caelangillon/microfluidic-pump/README.md

# microfluidic-pump

Colation of all software-relevant files of the Microfluidic Pump project.
May also contain some other files for document creation.
