caelangillon/microfluidic-pump/MATLAB/README.MD

# MATLAB Files
MATLAB prototyping files, includes:
- Simulations
- Prototype Arduino build files (Simulink)
- Testing UI and data
