caelangillon/microfluidic-pump/Diagrams/methodology.png

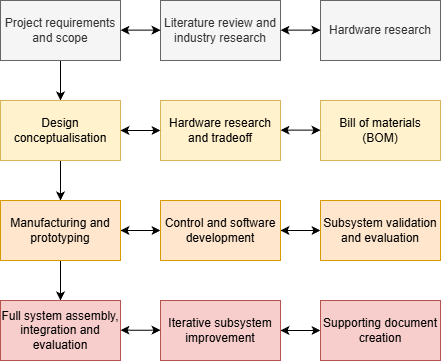
Diagrams/methodology.png
