caelangillon/microfluidic-pump/Diagrams/parallelmethod.png

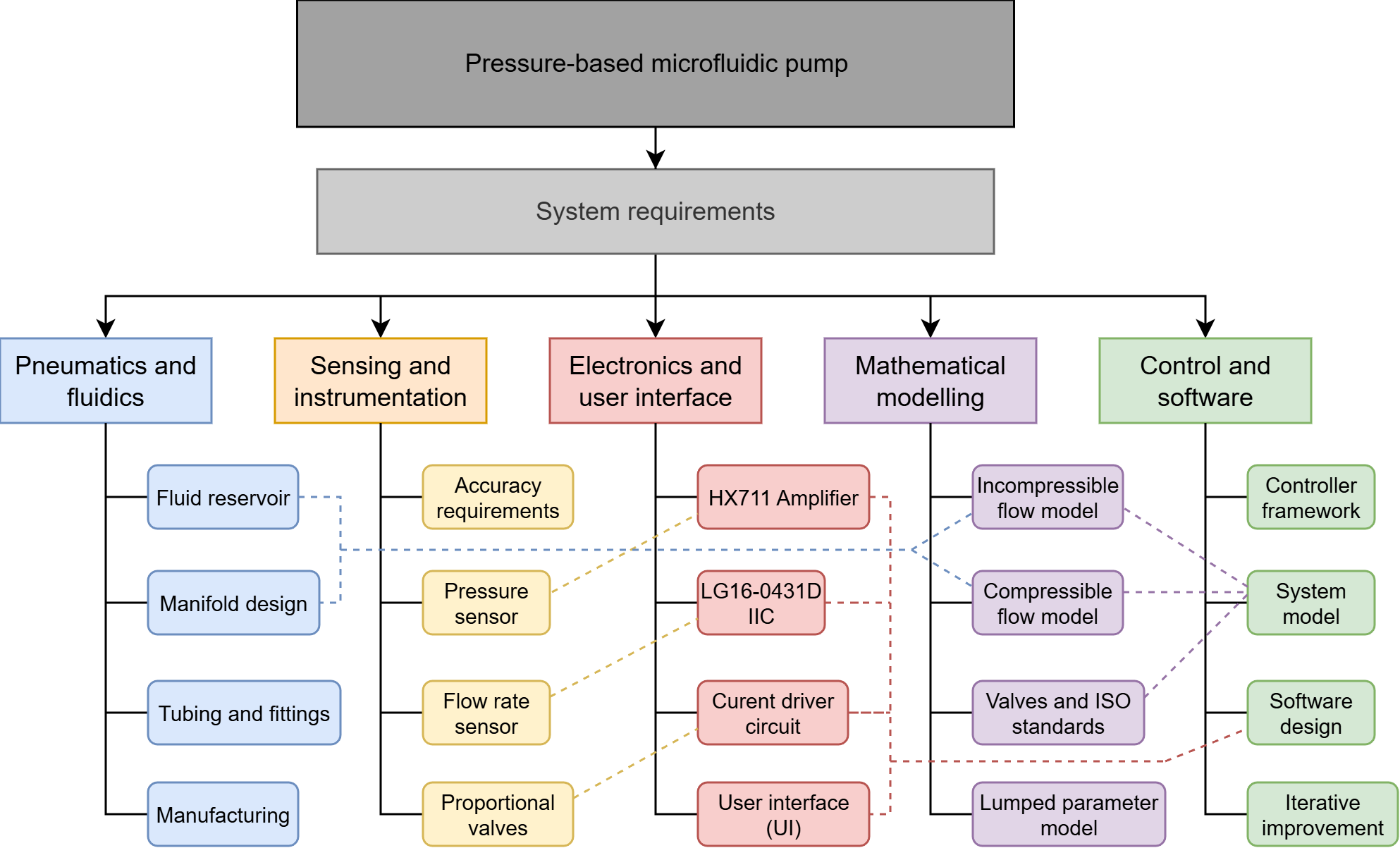
Diagrams/parallelmethod.png
