caelangillon/microfluidic-pump/Diagrams/Preliminary Circuit Layout.png

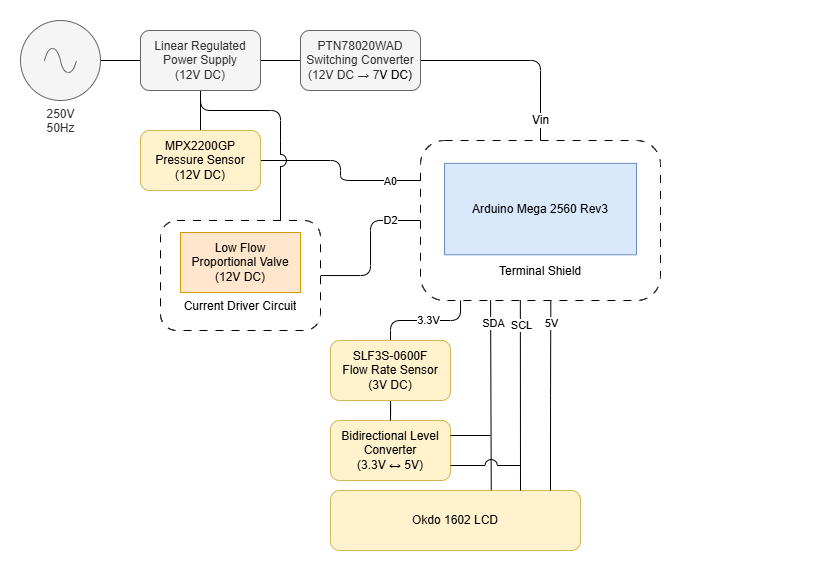
Diagrams/Preliminary Circuit Layout.png
