caelangillon/microfluidic-pump/Diagrams/Semester Breakdown.png

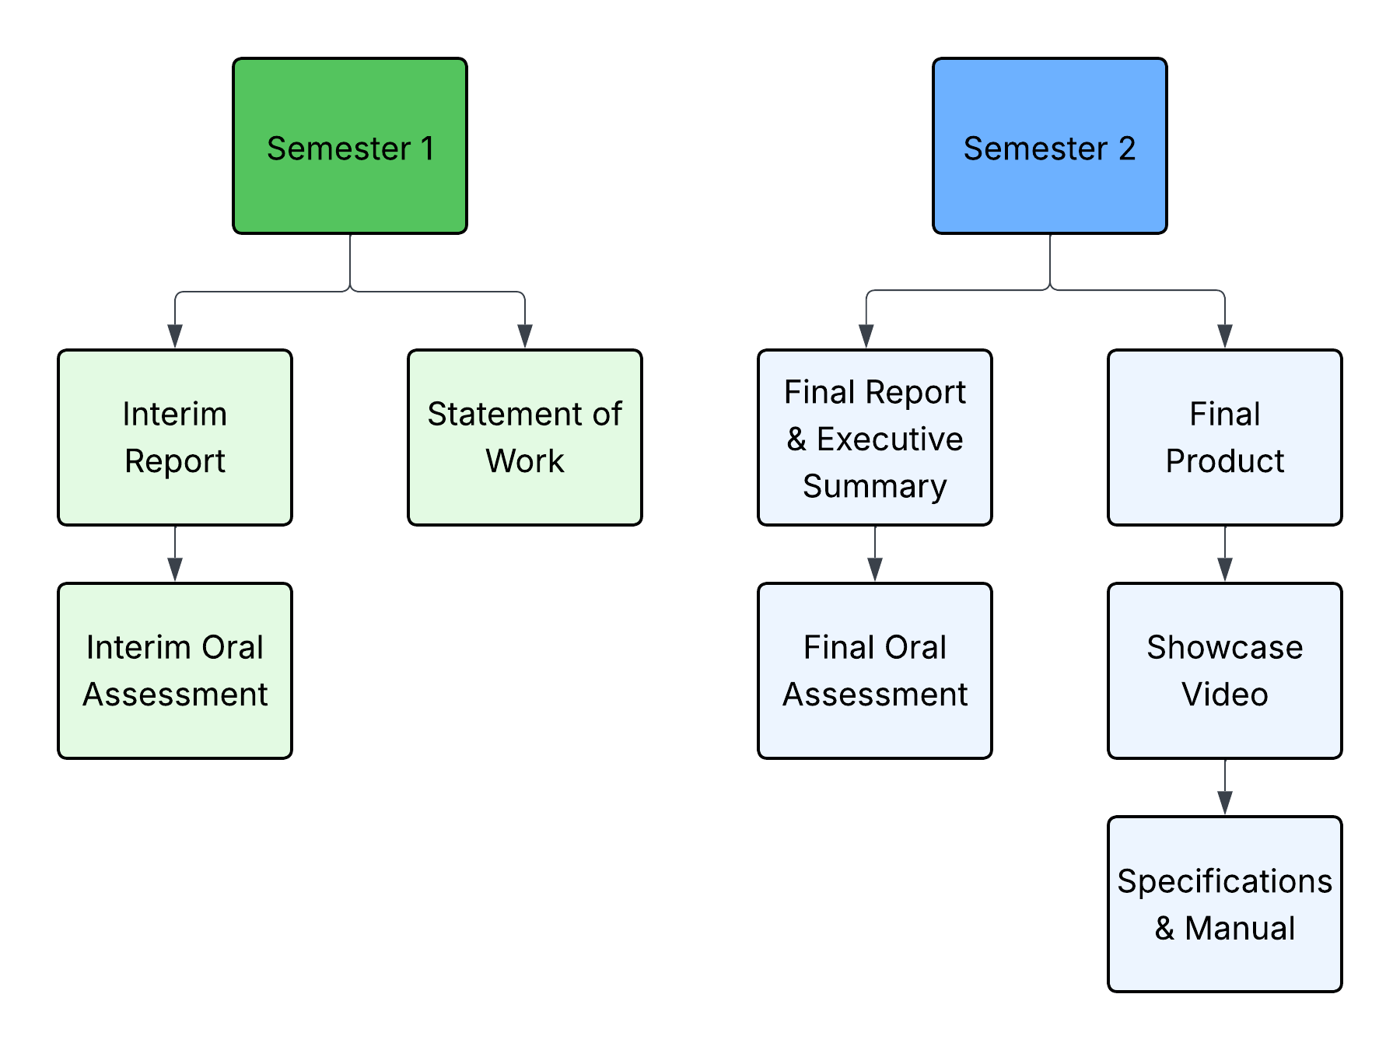
Diagrams/Semester Breakdown.png
