caelangillon/microfluidic-pump/Diagrams/Stakeholders.png

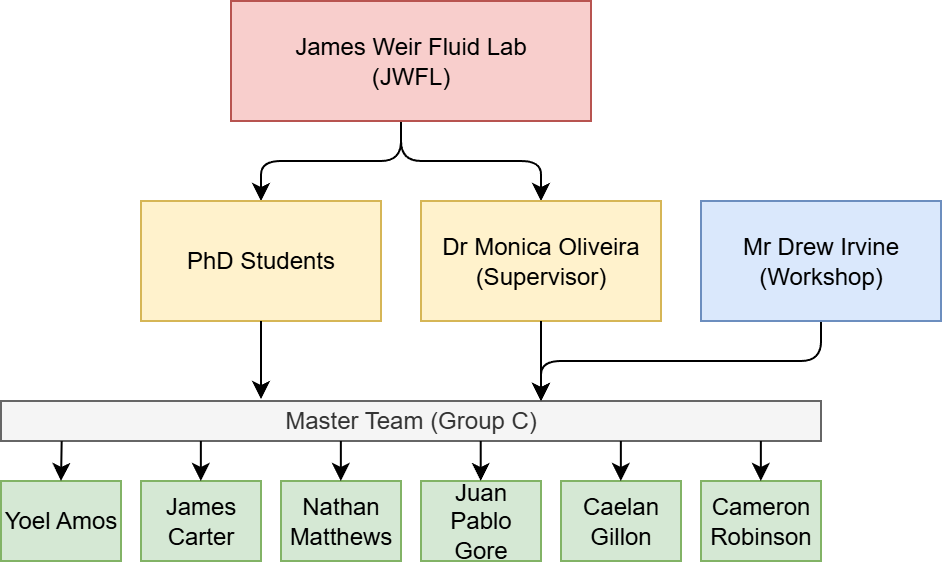
Diagrams/Stakeholders.png
