caelangillon/microfluidic-pump/Diagrams/Work Breakdown (Original).png

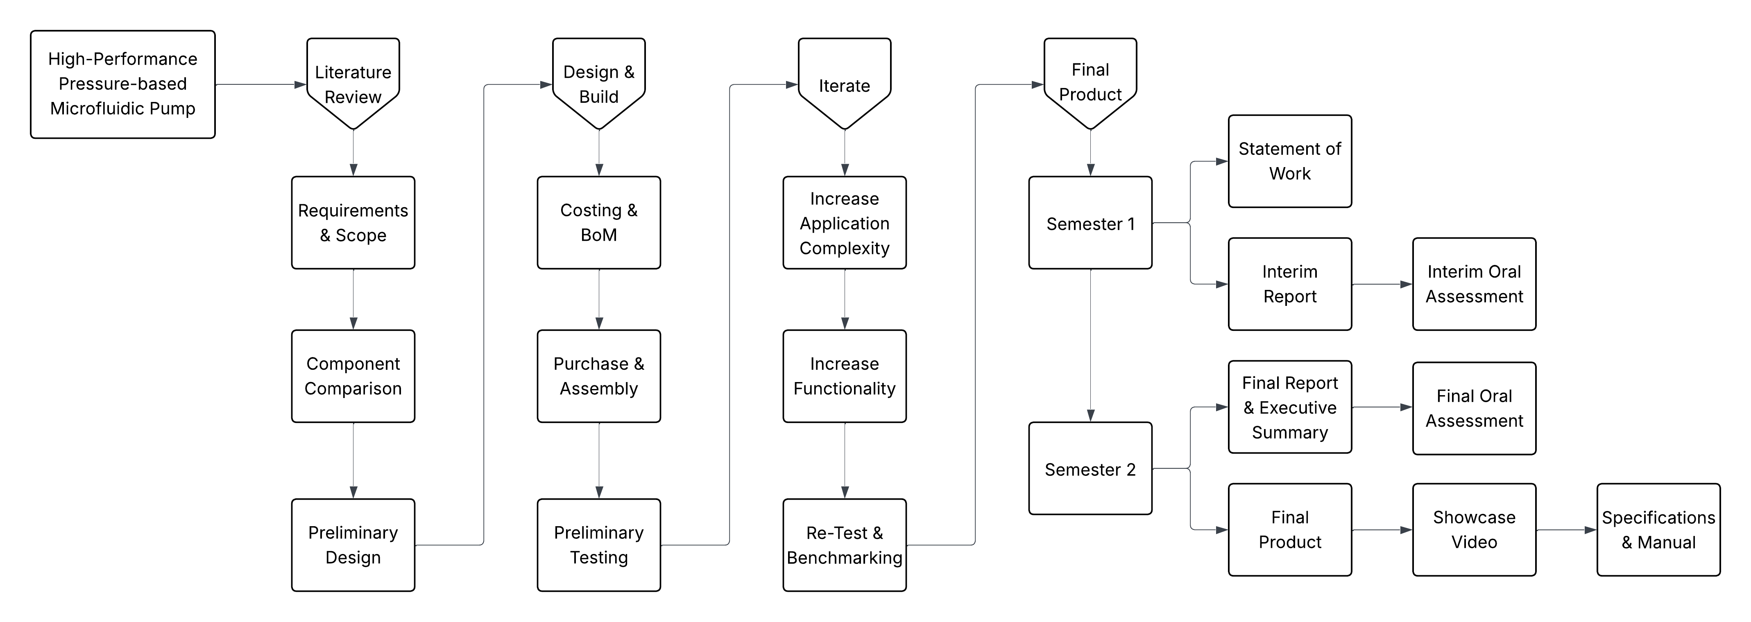
Diagrams/Work Breakdown (Original).png
