caelangillon/microfluidic-pump/Diagrams/Work Breakdown.png

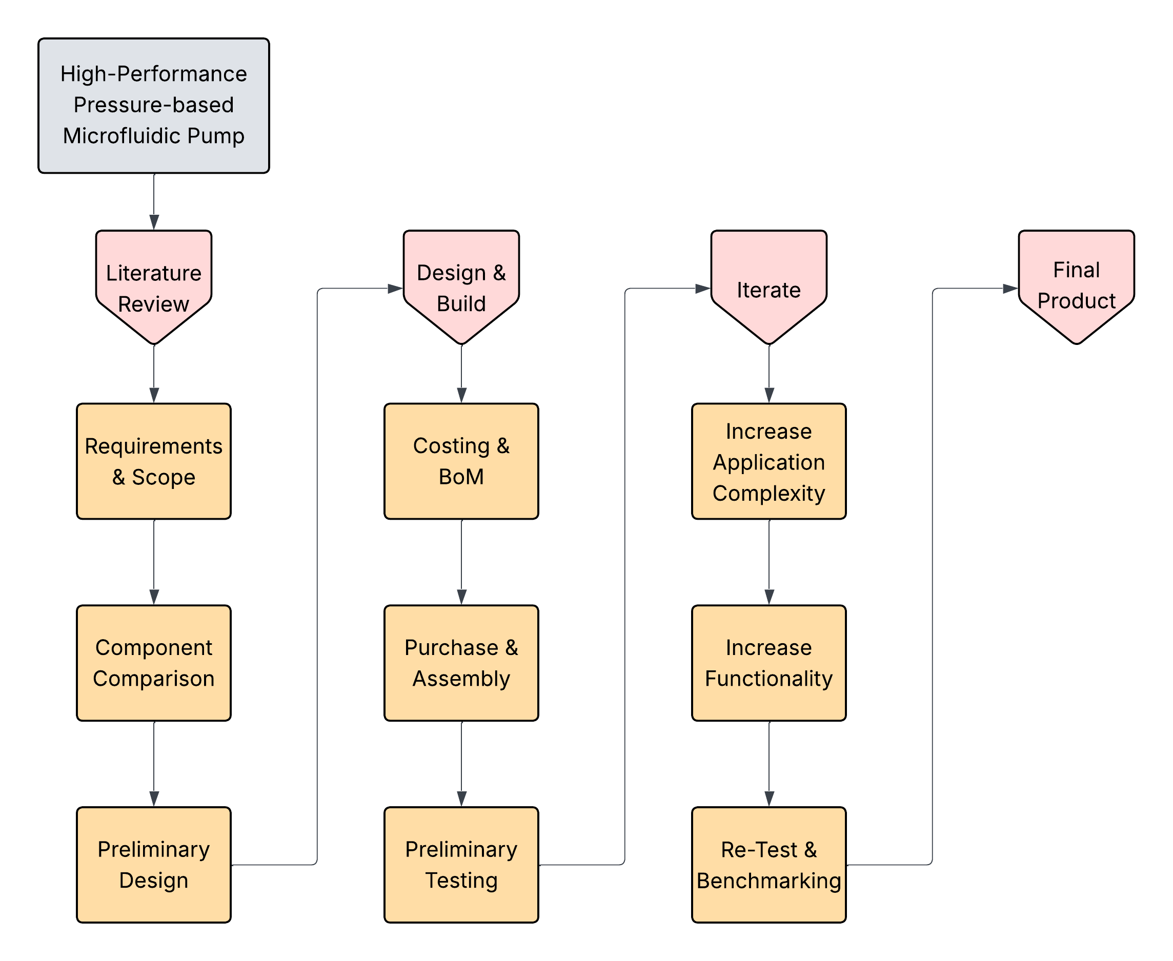
Diagrams/Work Breakdown.png
