caelangillon/microfluidic-pump/3D Prints/Reservoir Bottom.STL

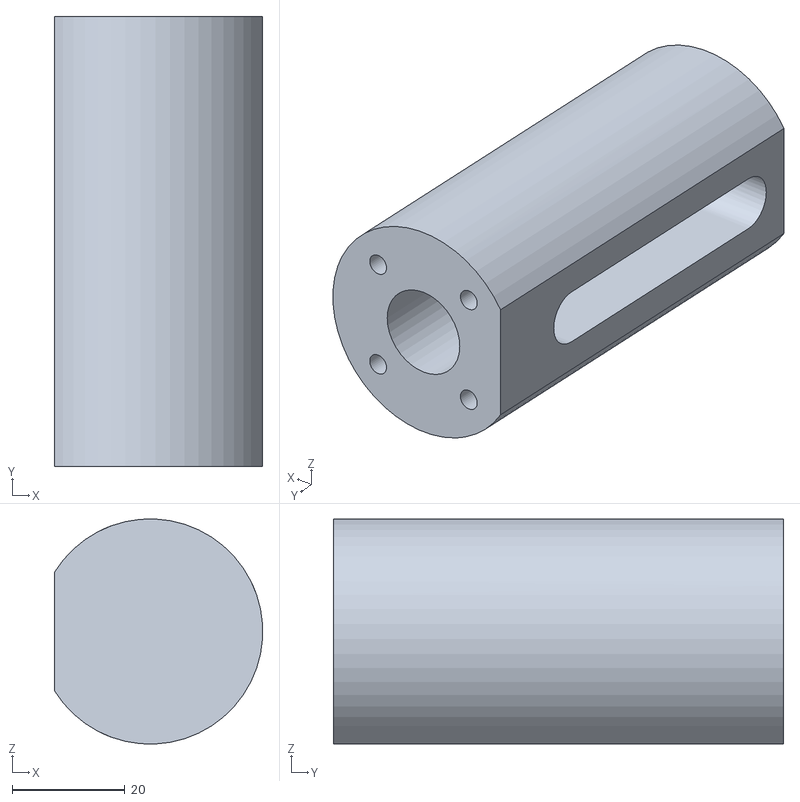
[picture p21: CAD file, 2025-11-24]
3D Prints/Reservoir Bottom.STL
37.0 x 80.0 x 40.0
