caelangillon/microfluidic-pump/3D Prints/Manifold.STL

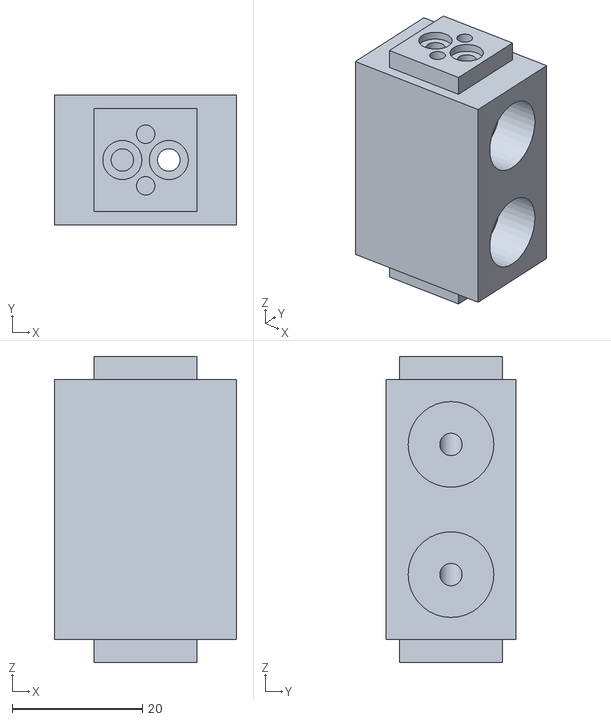
[picture p22: CAD file, 2025-11-24]
3D Prints/Manifold.STL
28.0 x 20.0 x 47.0
