caelangillon/microfluidic-pump/3D Prints/Reservoir Cap.STL

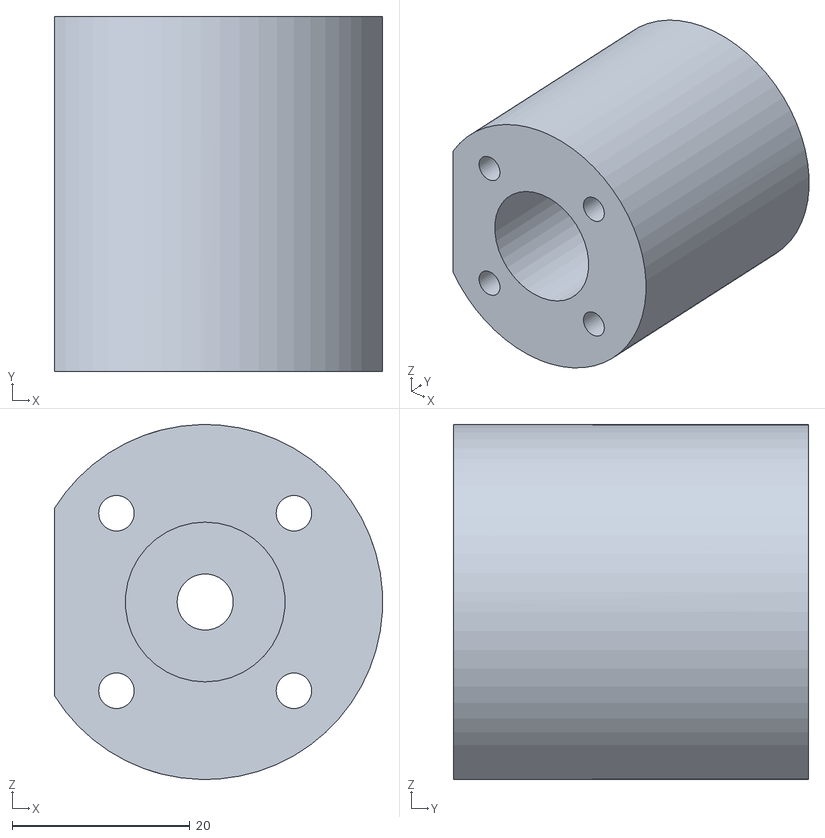
[picture p23: CAD file, 2025-11-24]
3D Prints/Reservoir Cap.STL
37.0 x 40.0 x 40.0
