caelangillon/microfluidic-pump/Diagrams/Assembly Instructions/manifold1.png

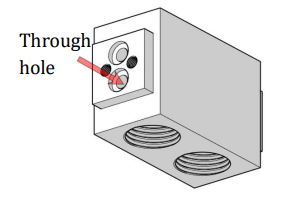
Diagrams/Assembly Instructions/manifold1.png
