caelangillon/microfluidic-pump/Diagrams/Assembly Instructions/manifold2.png

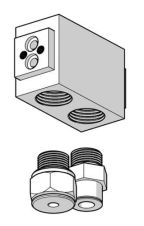
Diagrams/Assembly Instructions/manifold2.png
