caelangillon/microfluidic-pump/Diagrams/Assembly Instructions/manifold3.png

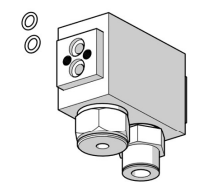
Diagrams/Assembly Instructions/manifold3.png
