caelangillon/microfluidic-pump/Diagrams/Assembly Instructions/manifold4.png

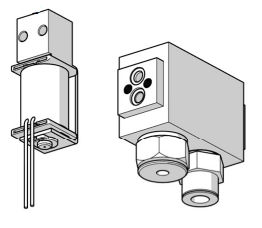
Diagrams/Assembly Instructions/manifold4.png
