caelangillon/microfluidic-pump/Diagrams/Assembly Instructions/manifold5.png

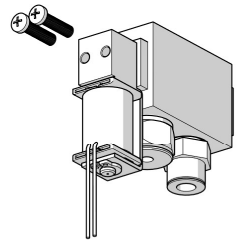
Diagrams/Assembly Instructions/manifold5.png
