caelangillon/microfluidic-pump/Diagrams/Assembly Instructions/manifold6.png

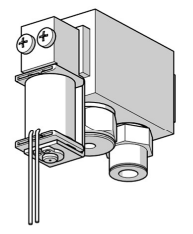
Diagrams/Assembly Instructions/manifold6.png
