caelangillon/microfluidic-pump/Diagrams/Assembly Instructions/manifold7.png

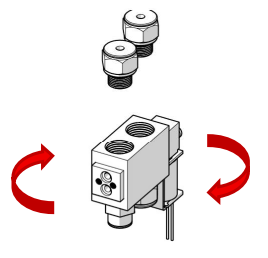
Diagrams/Assembly Instructions/manifold7.png
