caelangillon/microfluidic-pump/Diagrams/Assembly Instructions/manifold8.png

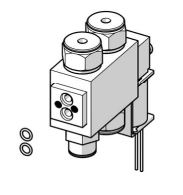
Diagrams/Assembly Instructions/manifold8.png
