caelangillon/microfluidic-pump/Diagrams/Assembly Instructions/manifold9.png

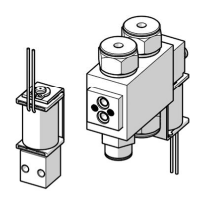
Diagrams/Assembly Instructions/manifold9.png
