caelangillon/microfluidic-pump/Diagrams/Assembly Instructions/manifold10.png

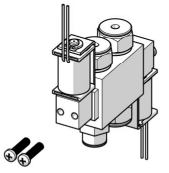
Diagrams/Assembly Instructions/manifold10.png
