caelangillon/microfluidic-pump/Diagrams/Assembly Instructions/manifold11.png

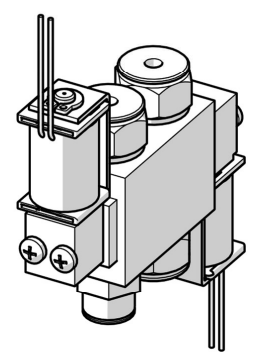
Diagrams/Assembly Instructions/manifold11.png
