caelangillon/microfluidic-pump/Diagrams/Assembly Instructions/reservoir1.png

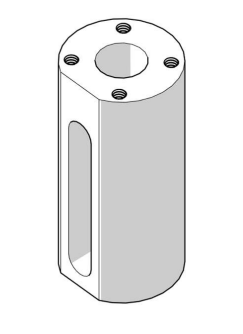
Diagrams/Assembly Instructions/reservoir1.png
