caelangillon/microfluidic-pump/Diagrams/Assembly Instructions/Reservoir3.png

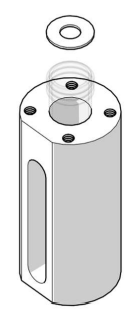
Diagrams/Assembly Instructions/Reservoir3.png
