caelangillon/microfluidic-pump/Diagrams/Assembly Instructions/Reservoir4.png

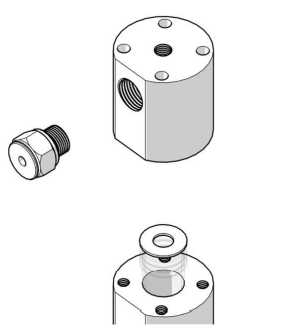
Diagrams/Assembly Instructions/Reservoir4.png
