caelangillon/microfluidic-pump/Diagrams/Assembly Instructions/Reservoir5.png

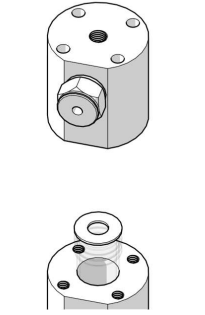
Diagrams/Assembly Instructions/Reservoir5.png
