caelangillon/microfluidic-pump/Diagrams/Assembly Instructions/Reservoir6.png

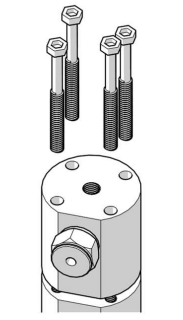
Diagrams/Assembly Instructions/Reservoir6.png
