caelangillon/microfluidic-pump/Diagrams/Assembly Instructions/Reservoir7.png

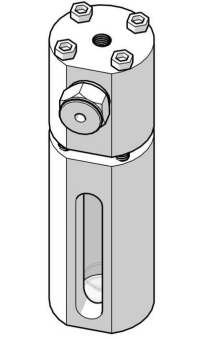
Diagrams/Assembly Instructions/Reservoir7.png
