caelangillon/microfluidic-pump/Diagrams/Assembly Instructions/restubing2.png

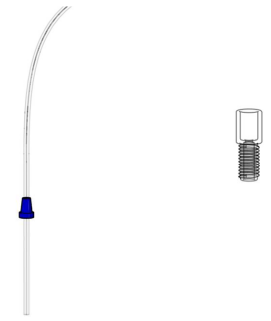
Diagrams/Assembly Instructions/restubing2.png
