caelangillon/microfluidic-pump/Diagrams/Assembly Instructions/restubing3.png

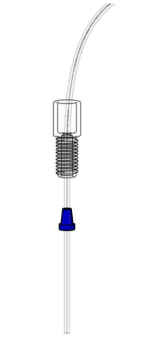
Diagrams/Assembly Instructions/restubing3.png
