caelangillon/microfluidic-pump/Diagrams/Assembly Instructions/restubing4.png

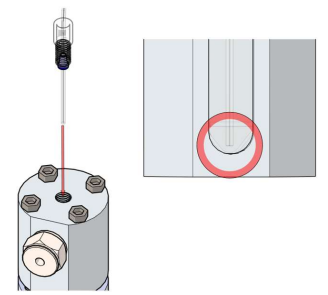
Diagrams/Assembly Instructions/restubing4.png
