caelangillon/microfluidic-pump/Diagrams/Assembly Instructions/restubing5.png

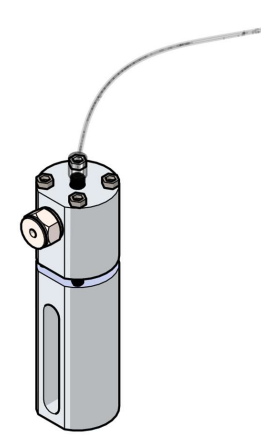
Diagrams/Assembly Instructions/restubing5.png
