caelangillon/microfluidic-pump/Results/frs_calib_test1.csv

6.999999999999999556e-01
2.427100000000000080e+02
1.000000000000000021e-02
2.000000000000000042e-02
2.000000000000000042e-02
1.000000000000000021e-02
1.000000000000000021e-02
0.000000000000000000e+00
1.000000000000000021e-02
1.000000000000000021e-02
0.000000000000000000e+00
0.000000000000000000e+00
0.000000000000000000e+00
1.000000000000000021e-02
2.427199999999999989e+02
1.000000000000000021e-02
0.000000000000000000e+00
0.000000000000000000e+00
1.000000000000000021e-02
1.000000000000000021e-02
1.000000000000000021e-02
1.000000000000000021e-02
0.000000000000000000e+00
1.000000000000000021e-02
0.000000000000000000e+00
2.427199999999999989e+02
2.427100000000000080e+02
2.427100000000000080e+02
2.427100000000000080e+02
2.427100000000000080e+02
1.000000000000000021e-02
0.000000000000000000e+00
0.000000000000000000e+00
1.000000000000000021e-02
1.000000000000000021e-02
0.000000000000000000e+00
2.427199999999999989e+02
2.427100000000000080e+02
2.427100000000000080e+02
2.427199999999999989e+02
0.000000000000000000e+00
2.427199999999999989e+02
0.000000000000000000e+00
0.000000000000000000e+00
2.427199999999999989e+02
1.000000000000000021e-02
0.000000000000000000e+00
0.000000000000000000e+00
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
