caelangillon/microfluidic-pump/Results/frs_calib_test3.csv

1.400000000000000133e-01
1.400000000000000133e-01
1.300000000000000044e-01
1.199999999999999956e-01
1.000000000000000056e-01
1.100000000000000006e-01
1.100000000000000006e-01
1.000000000000000056e-01
1.000000000000000056e-01
1.000000000000000056e-01
1.000000000000000056e-01
1.000000000000000056e-01
8.999999999999999667e-02
1.000000000000000056e-01
1.000000000000000056e-01
1.000000000000000056e-01
1.100000000000000006e-01
8.999999999999999667e-02
1.000000000000000056e-01
8.999999999999999667e-02
1.000000000000000056e-01
8.000000000000000167e-02
7.000000000000000666e-02
7.000000000000000666e-02
8.999999999999999667e-02
8.999999999999999667e-02
8.000000000000000167e-02
7.000000000000000666e-02
7.000000000000000666e-02
8.000000000000000167e-02
8.999999999999999667e-02
7.000000000000000666e-02
8.000000000000000167e-02
5.999999999999999778e-02
5.999999999999999778e-02
5.000000000000000278e-02
4.000000000000000083e-02
2.999999999999999889e-02
1.000000000000000021e-02
1.000000000000000021e-02
2.427199999999999989e+02
1.000000000000000021e-02
2.427199999999999989e+02
0.000000000000000000e+00
2.427100000000000080e+02
0.000000000000000000e+00
0.000000000000000000e+00
1.000000000000000021e-02
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
