caelangillon/microfluidic-pump/Results/frs_calib_test1.png

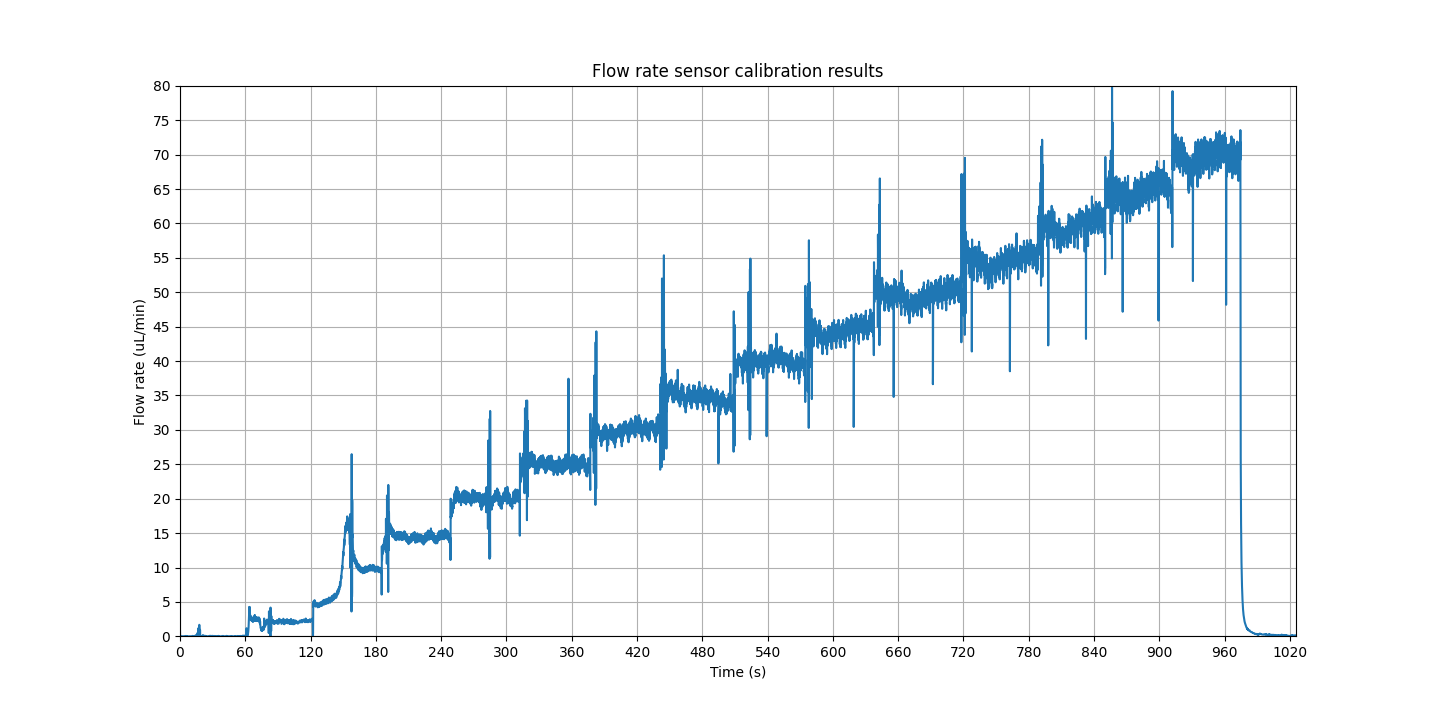
Results/frs_calib_test1.png
