caelangillon/microfluidic-pump/Results/frs_calib_test2.png

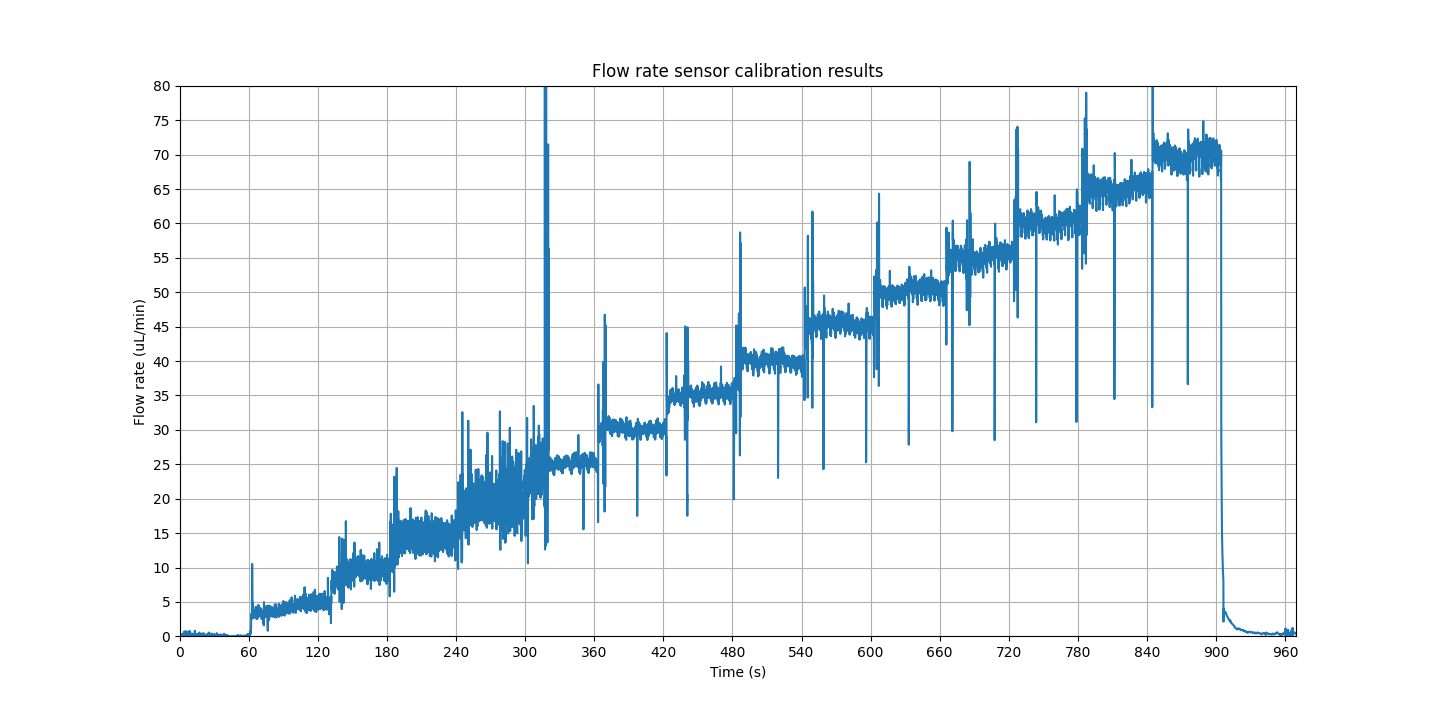
Results/frs_calib_test2.png
