caelangillon/microfluidic-pump/Results/frs_calib_test3.png

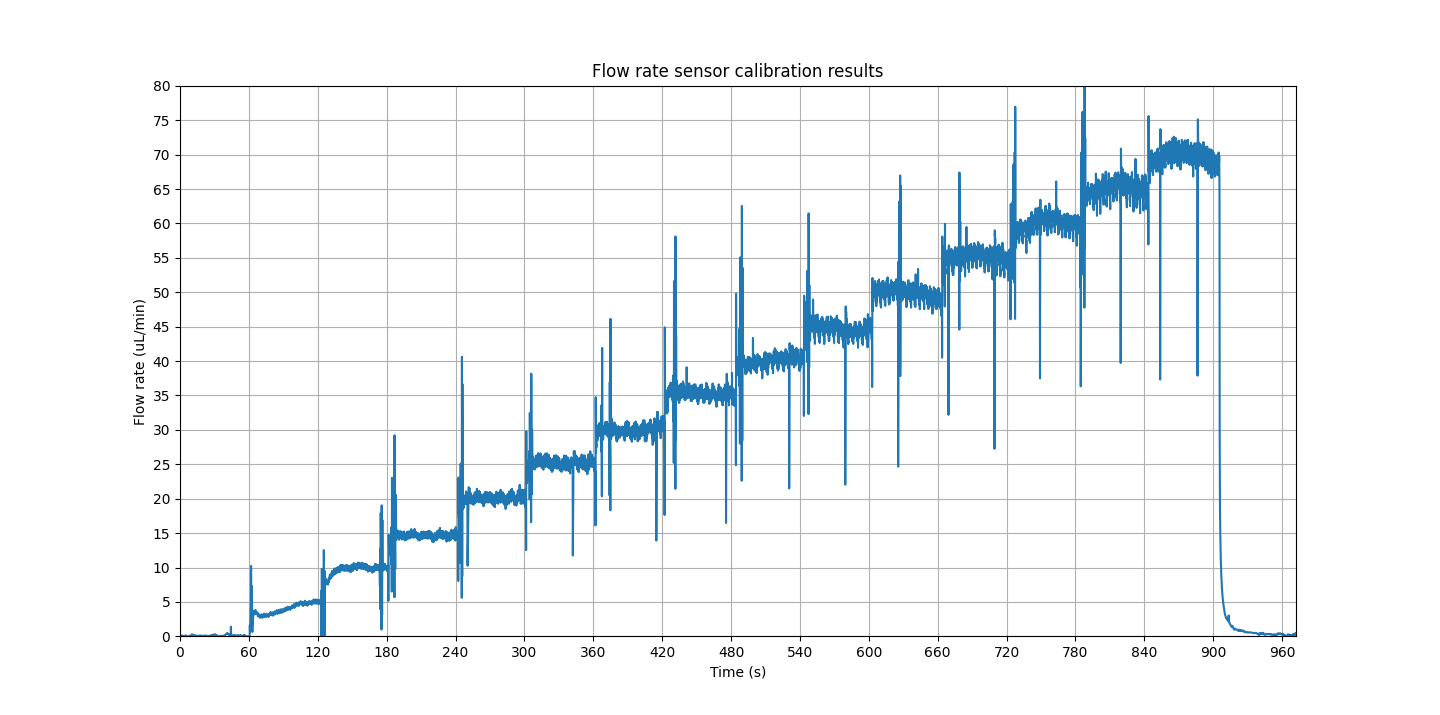
Results/frs_calib_test3.png
