caelangillon/microfluidic-pump/Results/frs_calib_test_all.png

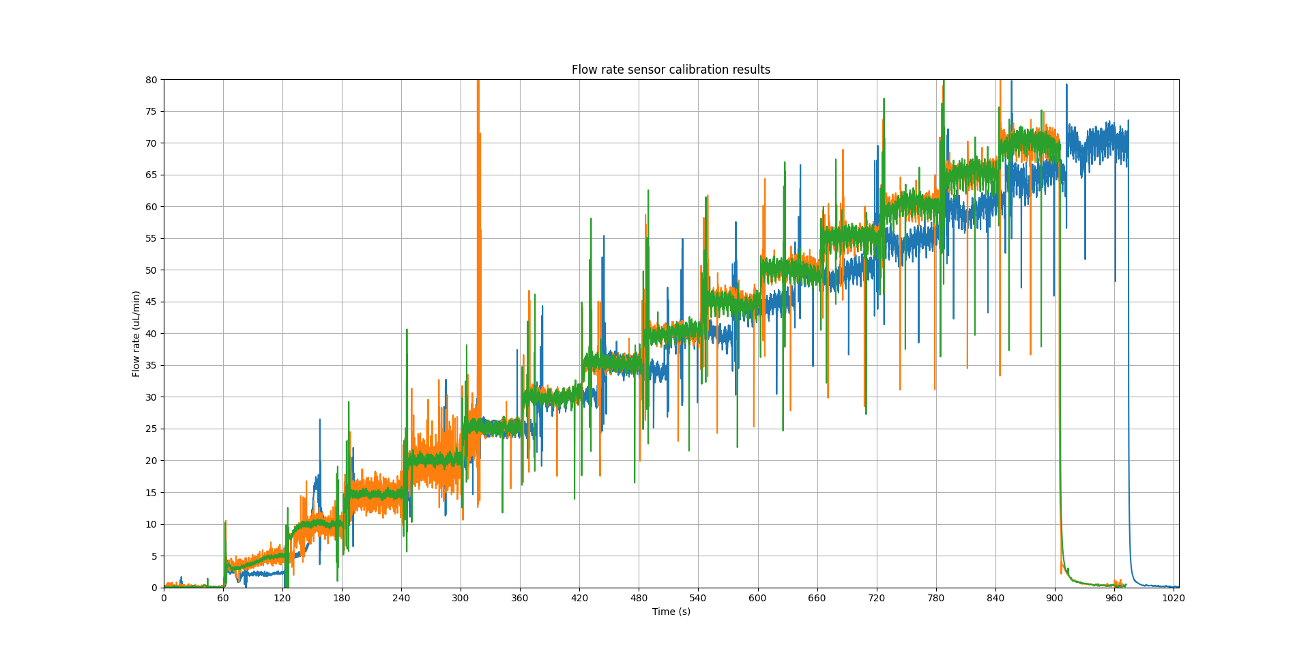
Results/frs_calib_test_all.png
