caelangillon/microfluidic-pump/Diagrams/Circuit Layout 2/Circuit Layout 2.pdf

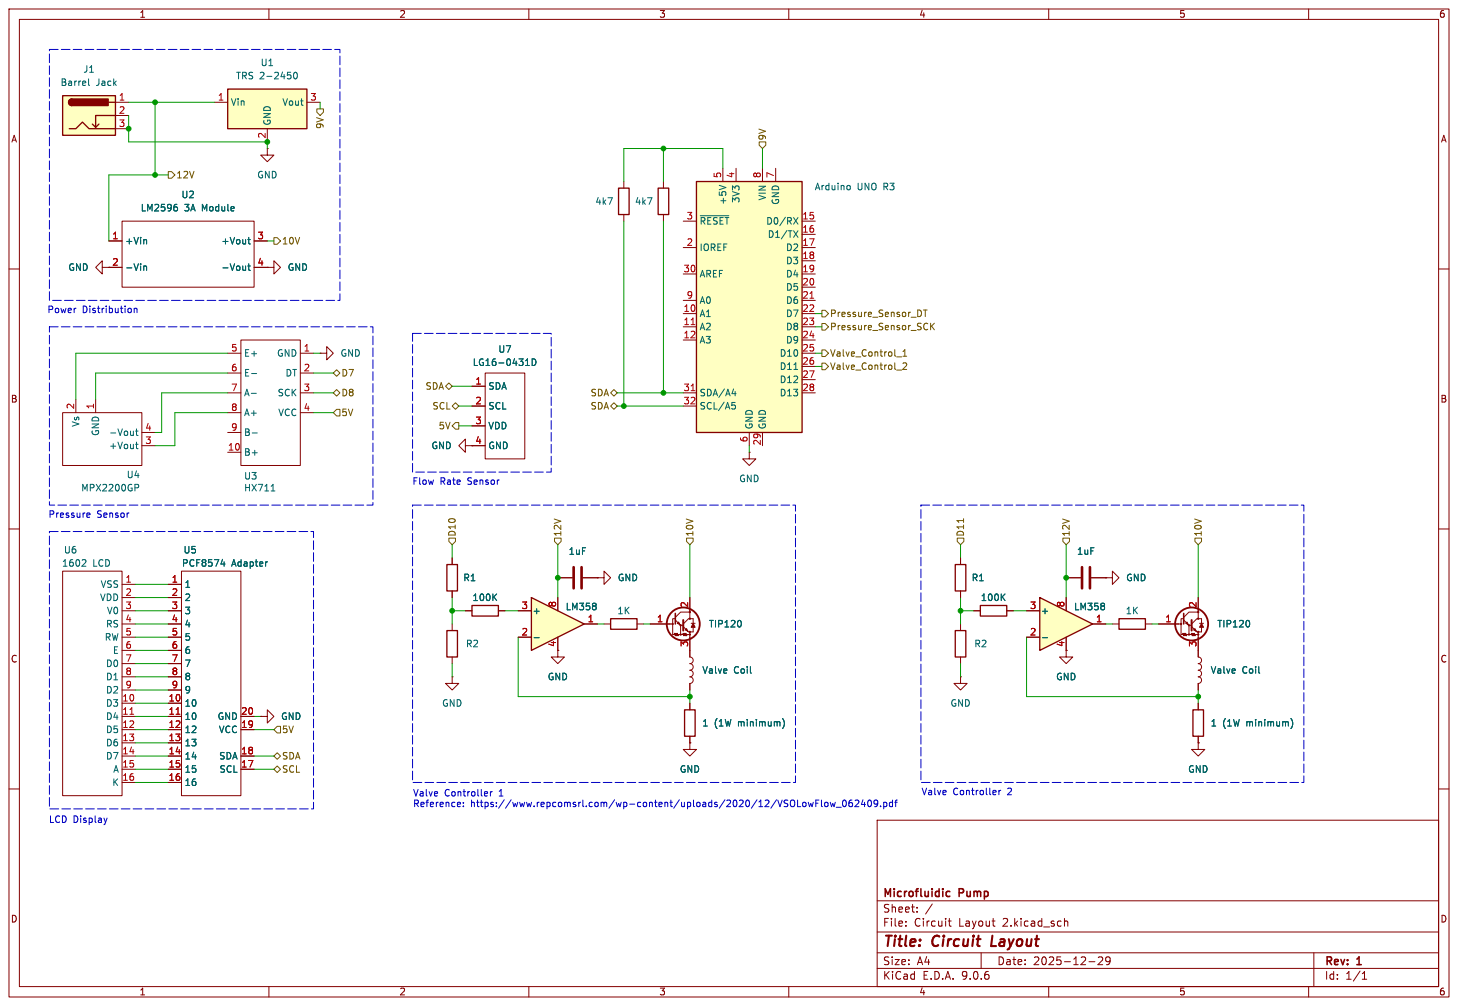
[picture p49: page 1]

2 3 TIP120 Valve Coil 1 (1W minimum) GND GND GND
