caelangillon/microfluidic-pump/(commit log)

2026-02-12 big update 12/02/2026
    [Circuit Layout 2.kicad_sch]
2026-02-12 big update 12/02/206
    [frs_calib_test1.csv, frs_calib_test2.csv, frs_calib_test3.csv, frs_calib_test4.csv]
2026-02-14 tidy up
    [frs_calib_test1.csv, frs_calib_test2.csv, frs_calib_test3.csv]
2026-02-22 Commited PID Test files
2026-02-22 Add README for PID test files
    Added README for PID test files with instructions for deployment, UI usage, and data saving.
2026-03-15 Big CPP update
    Added code for the controller(s), LCD and propValve. The controller PID loops need updated to include anti-windeup, and the propValve also needs updated with most recent working code.
2026-03-15 changed initial pid gains
2026-03-15 combined sensor functions into one file
2026-03-15 implemented PWM code
2026-03-16 some include fixes and ui commit
    [main_ui.py, propValves.cpp]
2026-03-16 removed commented reset function
    [controllers.cpp]
2026-03-17 Added capibility to recieve resistance from calibration
2026-03-17 added FR sensor scaling
2026-03-25 Added ui message and individual valve integrals
2026-03-25 made valve integrals independent
2026-03-25 Improved integral calculation and fixed windup
    [controllers.cpp]
2026-03-25 Fixed pwm duty cycle input
    [propValves.cpp]
2026-03-25 Sensor now reads negative flow
2026-03-25 fixed start time definition
    [targetGenerator.cpp]
